danieltyukov/tue-ec2/freq 0.5vpp.png

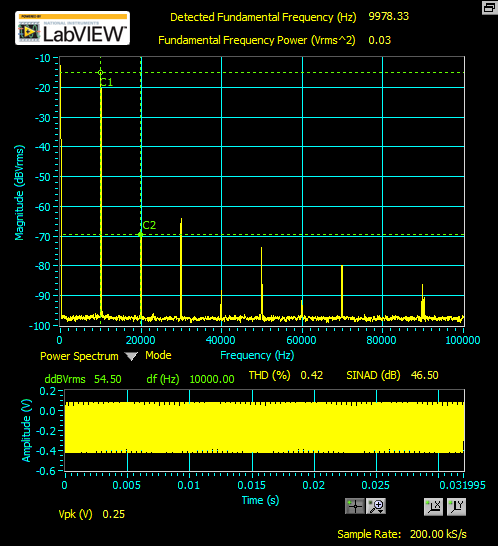
freq 0.5vpp.png
