danieltyukov/tue-ec2/freq 1vpp.png

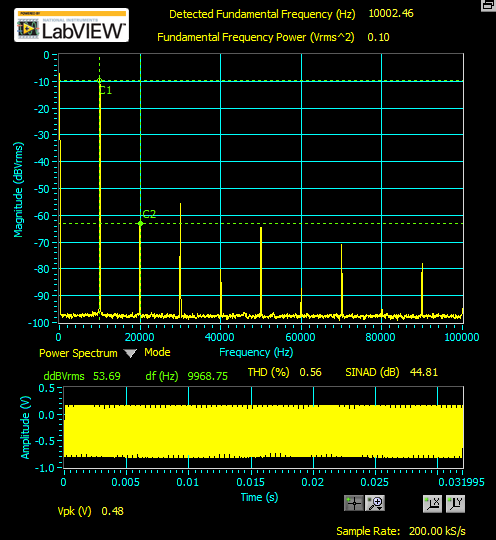
freq 1vpp.png
