danieltyukov/tue-ec2/freq 2vpp.png

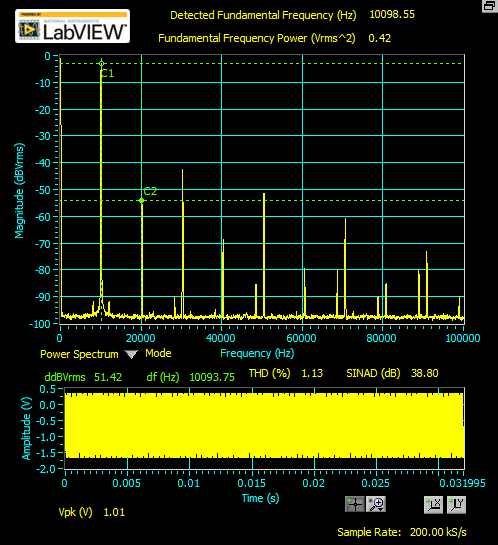
freq 2vpp.png
