danieltyukov/tue-ec2/freq no-filter 5vpp.png

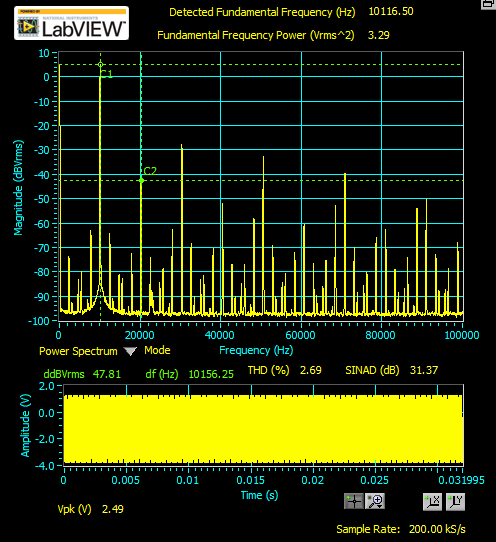
freq no-filter 5vpp.png
